liconaj/Bachelor-Thesis-AlamProject/docs/title.tex

\begin{titlepage}
    \begin{spacing}{1}
    \hypertarget{titlepage}{} % set hypertarget
    \bookmark[dest=titlepage,level=chapter]{Title Page} % add bookmark
    \begin{center}
        \vspace*{0.5cm}

        \LARGE
        % Development of a Portable and Modular Platform with Control System for Rod-Driven Continuum Parallel Robots
        \textbf{Design of a Portable Control Platform for Rod-Driven Continuum Parallel Robots}

        \vspace{2cm}
        \Large
        Josué Licona Mármol

        \large
        \vspace{1.5cm}
        \textit{A graduation project submitted in partial fulfillment \\
        of the requirements for the degree of} \\
        \vspace{0.5cm}
        Bachelor of Science in Mechanical Engineering

        \vspace{1.5cm}
        \textit{Supervisor} \\
        Jonathan Camargo Leyva, Ph.D.

        \vspace{1cm}
        % yellow and black version
        \adjincludegraphics[trim={0 0 {.5\width} 0},clip]{facultadingenieria}
        % black version
        %\includegraphics[width=0.4\textwidth, trim={{.5\width} 0 0 0},clip}]{facultadingenieria}
        \vspace{1cm}
        \\
        Department of Mechanical Engineering\\
        Universidad de los Andes\\
        Bogotá D.C., Colombia\\
        \today
    \end{center}
    \end{spacing}
\end{titlepage}
\setcounter{page}{2}
\normalsize
