liconaj/Bachelor-Thesis-AlamProject/docs/main.tex

\documentclass[a4paper,12pt,oneside]{book}
\usepackage{preamble}

\begin{document}

%=======================================
\frontmatter

\import{}{title}

% dedication
\addbookmark{Dedication}
\import{sections/}{dedication}
\normalsize

% abstract
\phantomchapter{Abstract}
\import{sections/}{abstract}

% acknowledgements
\phantomchapter{Acknowledgements}
\import{sections/}{acknowledgements}

% table of contents
\addbookmark{\contentsname}
\tableofcontents

% list of figures
\addcontent{\listfigurename}
\listoffigures

% list of tables
\addcontent{\listtablename}
\listoftables

%=======================================
\mainmatter

\chapter{Introduction}
\import{sections/}{introduction}

\chapter{Target Robot Structure}
\import{sections/}{chapter2}

\chapter{Linear Actuator}
\import{sections/}{chapter3}

\chapter{Platform Assembly}
\import{sections/}{chapter4}

\chapter{Control System Interface}
\import{sections/}{chapter5}

\chapter{Performance and Results}
\import{sections/}{chapter6}

%=======================================
\backmatter

\chapter{Conclusions}
\import{sections/}{conclusions}

\chapter{Future Work and Recommendations}
\import{sections/}{future}

% references
%\nocite{*}  % show all references
\printbibliography[
    heading=bibintoc,
    title={Bibliography}]

%=======================================
% appendices

\begin{appendices}
    \renewcommand{\thechapter}{}
    \renewcommand{\thesection}{\Alph{section}}
    %\addtocontents{toc}{\protect\setcounter{tocdepth}{1}}
    %\makeatletter
    %\addtocontents{toc}{%
    %\begingroup
    %\let\protect\l@chapter\protect\l@section
    %\let\protect\l@section\protect\l@subsection
    %}

    \section{Forces in Actuator Arm}\label{apx:arm-calcs}
    \import{appendices/}{arm-forces-calcs}

    \section{PID Tuning Code}\label{apx:pid-code}
    \import{appendices/}{pid-code}

    \section{Test Code}\label{apx:test-code}
    \import{appendices/}{test-code}

    \section{Command Line Interface Source Code}\label{apx:cli-code}
    \import{appendices/}{cli-code}

    \section{Firmware Source Code}\label{apx:firmware-code}
    \import{appendices/}{firmware-source-code}    
\end{appendices}

\end{document}
