liconaj/Bachelor-Thesis-AlamProject/docs/sections/acknowledgements.tex

\par I would like to express my sincerest gratitude to God, whose guidance has been a constant source of support throughout my life. I am particularly grateful to my family, especially my mother, whose unwavering encouragement has been a significant source of strength.
\par I am indebted to the professors who have not only imparted their knowledge but also served as exemplary mentors, shaping my understanding and passion for mechanical engineering. I would also like to express my gratitude to my classmates for their camaraderie and support. \par I would also like to extend my gratitude to Daniel Álvarez for his invaluable contribution to the actuator concept and to Santiago Usme for his assistance with the manufacturing and assembly challenges.
