liconaj/Bachelor-Thesis-AlamProject/docs/sections/conclusions.tex

The development of the Alam robot platform has demonstrated the successful integration if mechanical design, control theory, and software development throughout this project. The platform, constructed from steel rod segments and 3D-printed components, provides a robust framework for robotic experimentation and control. Notwithstanding the difficulties encountered in the completion and the electronic assembly, the platform succeeded in attaining its principal objective of offering a flexible and programmable robotic system.

The testing and experimentation phase revealed both the platform's achievements and areas for improvement. The implementation of PID control algorithms demonstrated effective position control; however, issues with overshoot and controller saturation necessitated further refinement. The difficulties encountered with linear actuators highlighted the necessity for precision manufacturing and iterative design enhancements. These insights will inform future iterations aimed at optimizing performance and reliability.

The scalability of the platform was a fundamental aspect of the overarching objective. The design and architecture provide a robust foundation for the expansion of functionality in both in software and hardware. The modular nature of the system allows for straightforward incorporation of supplementary sensors, actuators, and peripherals, thereby facilitating enhancements and customization based on specific requirements. The firmware was designed in such a way that the new commands and features can be added with a minimum of reconfiguration. Moreover, the use of standardized communication protocols guarantees compatibility with a multitude of external devices and systems. This inherent flexibility positions the platform for future developments and applications, thereby rendering it a versatile and scalable solution for various robotic projects.

In summary, the Alam robot platform serves as a foundational tool for the exploration of advanced robotics concepts and applications. By addressing challenges in mechanical design, control algorithms, and software integration, this project sets a precedent for future developments in the field of robotics.
