liconaj/Bachelor-Thesis-AlamProject/docs/sections/dedication.tex

\vspace*{2cm}

\large
\begin{flushleft}
    \noindent\textit{To my mother, Gildes Ester.}
\end{flushleft}

\vspace*{5cm}

\begin{flushright}
    \normalsize
    Success is the sum of small efforts, repeated day in, and day out. \\ --- Robert Collier
\end{flushright}
