liconaj/Bachelor-Thesis-AlamProject/docs/images/delta_robot.png

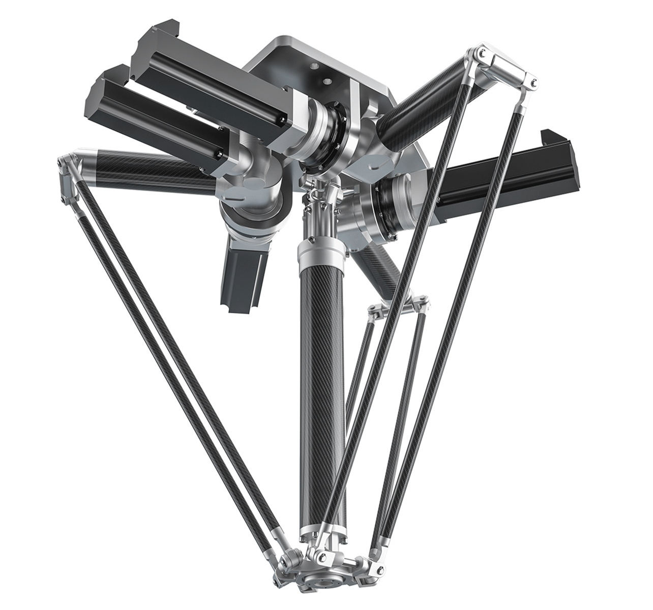
docs/images/delta_robot.png
