liconaj/Bachelor-Thesis-AlamProject/docs/images/main-connection.png

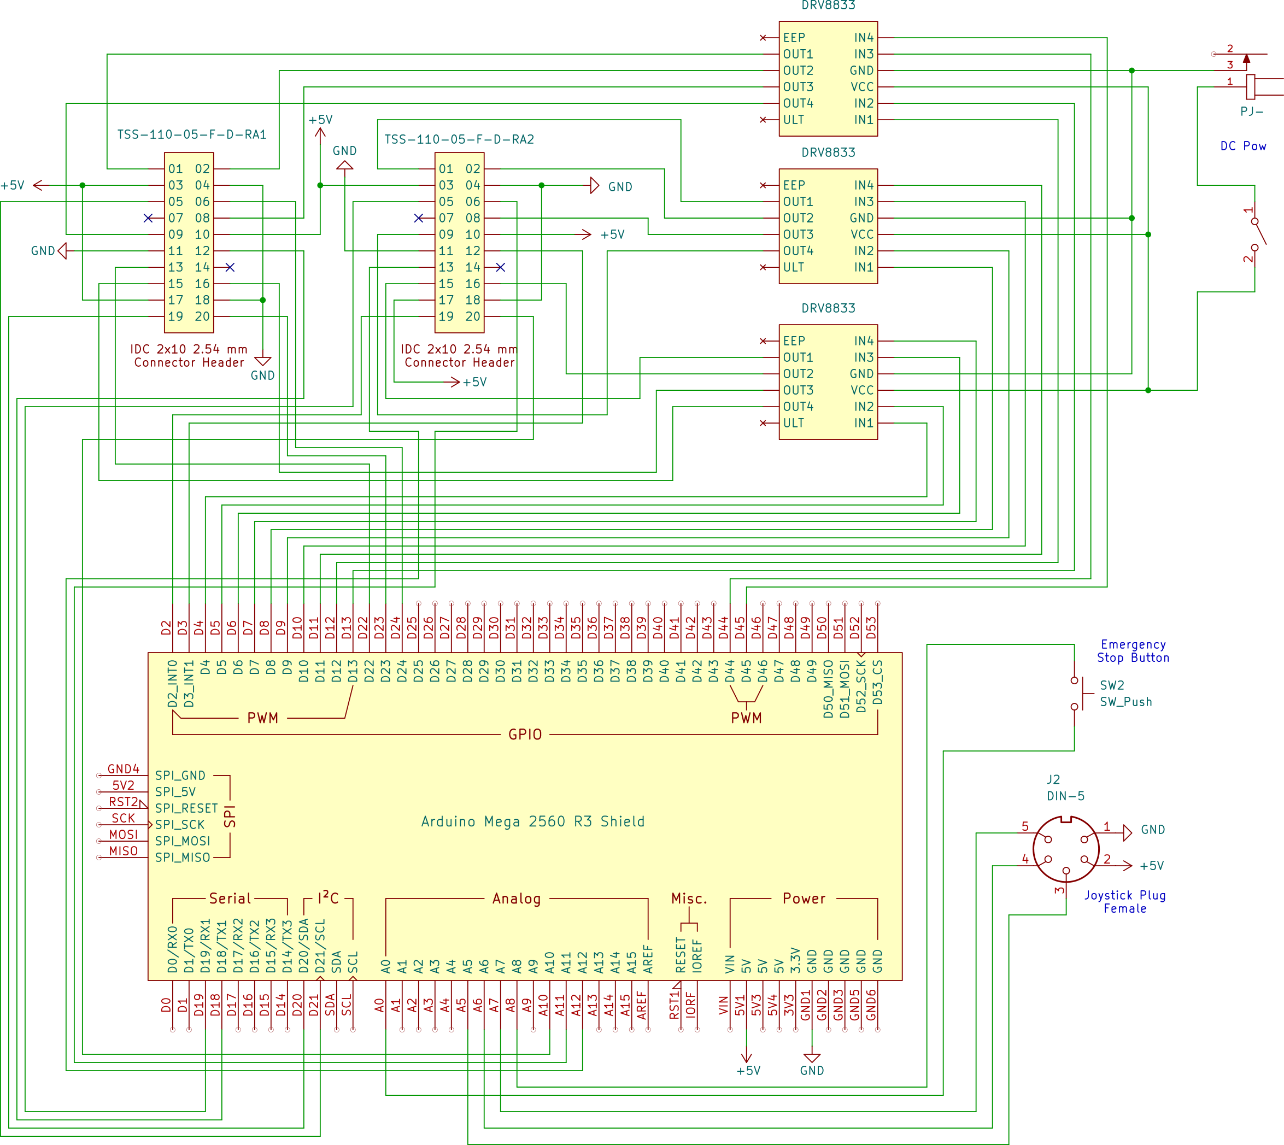
docs/images/main-connection.png
