liconaj/Bachelor-Thesis-AlamProject/docs/images/motor-connection.png

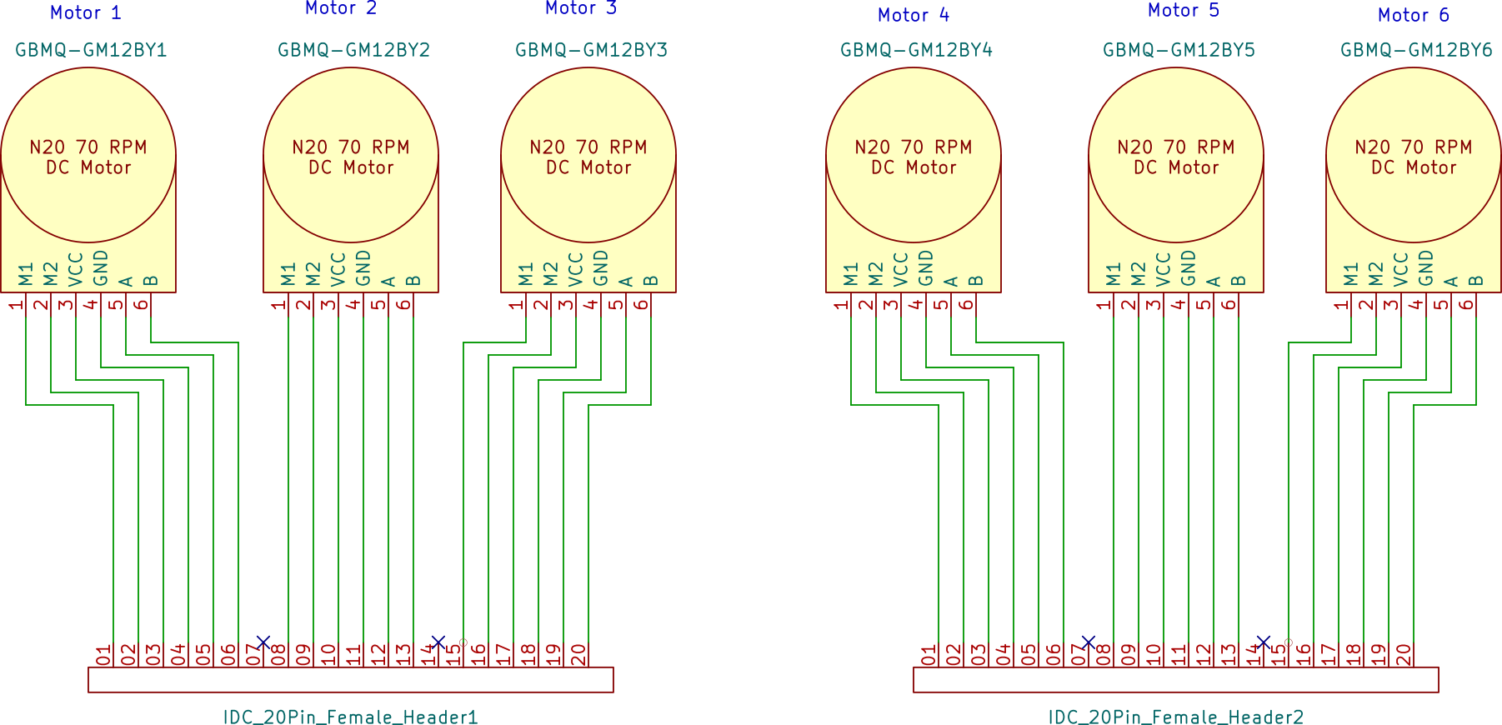
docs/images/motor-connection.png
