liconaj/Bachelor-Thesis-AlamProject/docs/appendices/test-code.tex

\begin{minted}[
    frame=lines,
    framesep=2mm,
    baselinestretch=0.9,
    fontsize=\footnotesize
    ]{gcode}
;ALAM ROBOT TEST
;BY LICONAJ (c) 2024

G4 P5000  ; WAIT 3 SECONDS
;MOVE ACTUATOR A
G1 A-60
G4 P500
G1 A0
G4 P500
;MOVE ACTUATOR B
G1 B-60
G1 P500
G1 B0
G4 P500
;MOVE ACTUATOR C
G1 C-60
G1 C0
;MOVE ACTUATORS A AND B
G4 P1000
G1 A-60 B-60
G4 P500
G1 A0 B0
;MOVE ACTUATORS B AND C
G4 P1000
G1 B-60 C-60
G4 P500
G1 B0 C0
;MOVE ACTUATORS C AND A
G4 P1000
G1 C-60 A-60
G4 P500
G1 C0 A0
;MOVE ALL ACTUATORS
G4 P1000
G1 A-60 B-60 C-60
G4 P1000
;MOVE ACTUATORS A B C TO HOME
G28 A B C
\end{minted}
