liconaj/Bachelor-Thesis-AlamProject/docs/images/input-output-signals.pdf

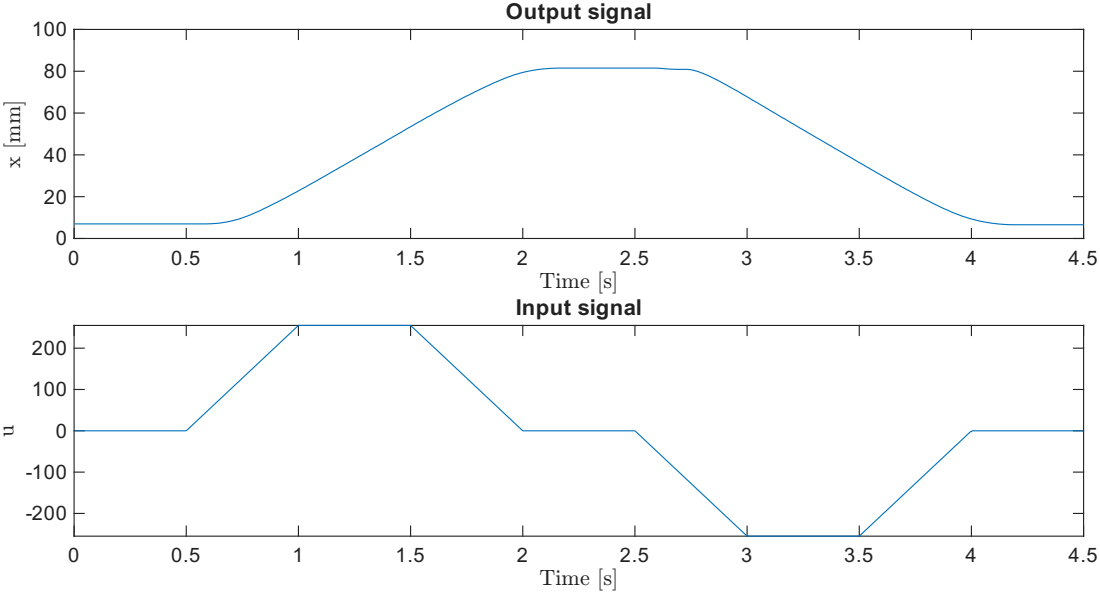
[picture p67: page 1]
