liconaj/Bachelor-Thesis-AlamProject/docs/images/facultadingenieria-eps-converted-to.pdf

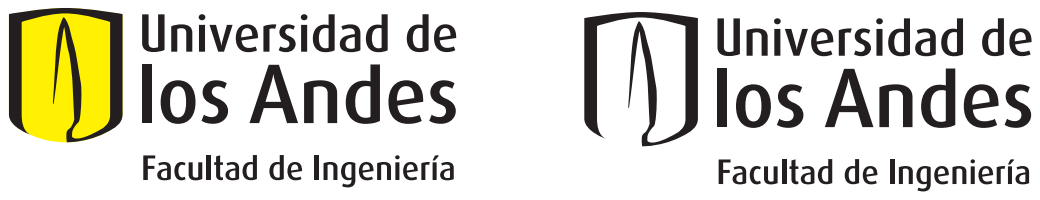
[picture p68: page 1]
