liconaj/Bachelor-Thesis-AlamProject/docs/schematic/main_connection.kicad_sch

## KiCad design docs/schematic/main_connection.kicad_sch (2024-06-28)

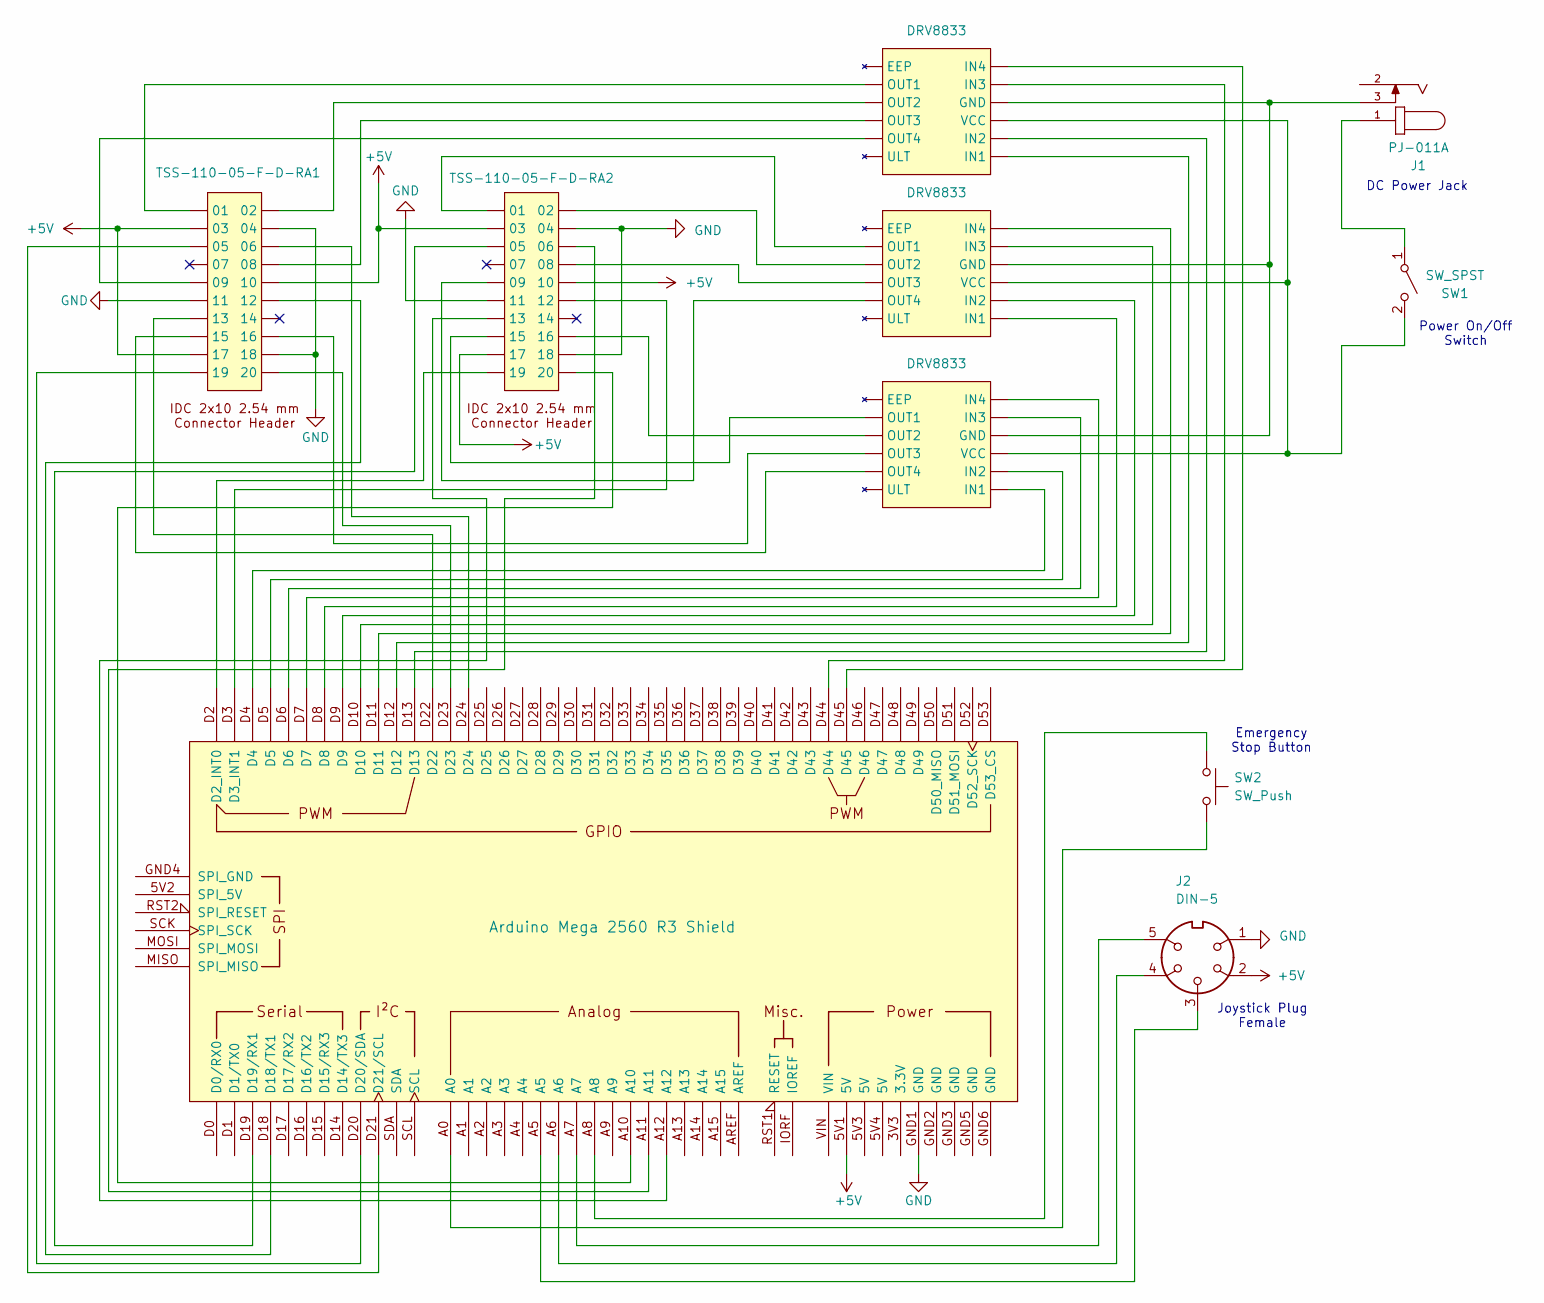
[picture p69: schematic main_connection.kicad_sch]

Parts:
A1: Arduino Mega 2560 R3 Shield; Arduino_Mega2560_R3_Shield
DRV8833: (no value)
J1: PJ-011A; CUI_PJ-011A
J2: DIN-5
SW1: SW_SPST
SW2: SW_Push
TSS-110-05-F-D-RA1, TSS-110-05-F-D-RA2: (no value)

Connections:
+5V: A1.5V1 (5V), J2.2, TSS-110-05-F-D-RA1., TSS-110-05-F-D-RA2.
GND: A1.GND1 (GND), J2.1, TSS-110-05-F-D-RA1., TSS-110-05-F-D-RA2.
unnamed: A1.A0, SW2.2
unnamed: A1.A5, J2.3
unnamed: A1.A6, J2.4
unnamed: A1.A7, J2.5
unnamed: A1.A8, SW2.1
unnamed: A1.A10, TSS-110-05-F-D-RA2.
unnamed: A1.A11, TSS-110-05-F-D-RA2.
unnamed: A1.A12, TSS-110-05-F-D-RA2.
unnamed: A1.D2 (D2_INT0), TSS-110-05-F-D-RA2.
unnamed: A1.D3 (D3_INT1), TSS-110-05-F-D-RA2.
unnamed: A1.D4, DRV8833.
unnamed: A1.D5, DRV8833.
unnamed: A1.D6, DRV8833.
unnamed: A1.D7, DRV8833.
unnamed: A1.D8, DRV8833.
unnamed: A1.D9, DRV8833.
unnamed: A1.D10, DRV8833.
unnamed: A1.D11, DRV8833.
unnamed: A1.D12, DRV8833.
unnamed: A1.D13, DRV8833.
unnamed: A1.D18 (D18/TX1), TSS-110-05-F-D-RA1.
unnamed: A1.D19 (D19/RX1), TSS-110-05-F-D-RA2.
unnamed: A1.D20 (D20/SDA), TSS-110-05-F-D-RA1.
unnamed: A1.D21 (D21/SCL), TSS-110-05-F-D-RA1.
unnamed: A1.D22, TSS-110-05-F-D-RA1.
unnamed: A1.D23, TSS-110-05-F-D-RA1.
unnamed: A1.D24, TSS-110-05-F-D-RA1.
unnamed: A1.D44, DRV8833.
unnamed: A1.D45, DRV8833.
unnamed: DRV8833., J1.3, SW1.2 (B), TSS-110-05-F-D-RA1., TSS-110-05-F-D-RA2.
unnamed: J1.1, SW1.1 (A)

Notes on the sheet:
DC Power Jack
Power On/Off Switch
Joystick Plug Female
Emergency Stop Button
