liconaj/Bachelor-Thesis-AlamProject/docs/schematic/motor_connection.kicad_sch

## KiCad design docs/schematic/motor_connection.kicad_sch (2024-07-04)

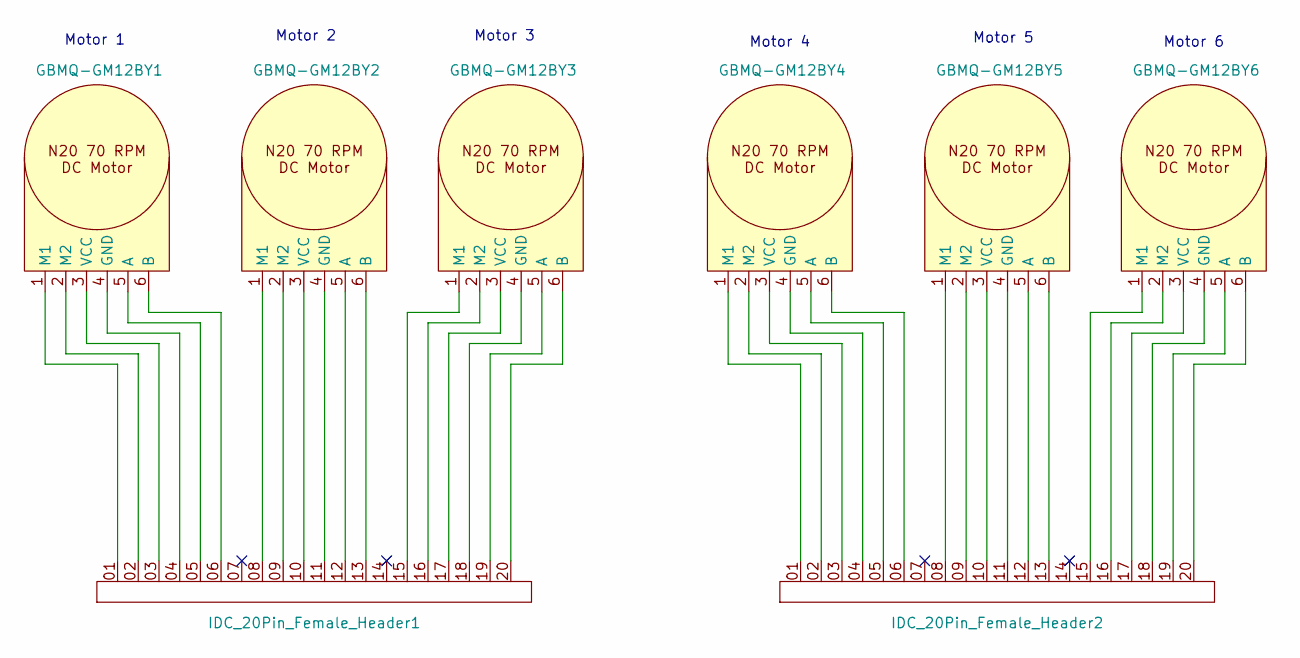
[picture p70: schematic motor_connection.kicad_sch]

Parts:
GBMQ-GM12BY1, GBMQ-GM12BY2, GBMQ-GM12BY3, GBMQ-GM12BY4, GBMQ-GM12BY5, GBMQ-GM12BY6: (no value)
IDC_20Pin_Female_Header1, IDC_20Pin_Female_Header2: (no value)

Connections:
unnamed: GBMQ-GM12BY1.1 (M1), IDC_20Pin_Female_Header1.01
unnamed: GBMQ-GM12BY1.2 (M2), IDC_20Pin_Female_Header1.02
unnamed: GBMQ-GM12BY1.3 (VCC), IDC_20Pin_Female_Header1.03
unnamed: GBMQ-GM12BY1.4 (GND), IDC_20Pin_Female_Header1.04
unnamed: GBMQ-GM12BY1.5 (A), IDC_20Pin_Female_Header1.05
unnamed: GBMQ-GM12BY1.6 (B), IDC_20Pin_Female_Header1.06
unnamed: GBMQ-GM12BY2.1 (M1), IDC_20Pin_Female_Header1.08
unnamed: GBMQ-GM12BY2.2 (M2), IDC_20Pin_Female_Header1.09
unnamed: GBMQ-GM12BY2.3 (VCC), IDC_20Pin_Female_Header1.10
unnamed: GBMQ-GM12BY2.4 (GND), IDC_20Pin_Female_Header1.11
unnamed: GBMQ-GM12BY2.5 (A), IDC_20Pin_Female_Header1.12
unnamed: GBMQ-GM12BY2.6 (B), IDC_20Pin_Female_Header1.13
unnamed: GBMQ-GM12BY3.2 (M2), IDC_20Pin_Female_Header1.16
unnamed: GBMQ-GM12BY3.3 (VCC), IDC_20Pin_Female_Header1.17
unnamed: GBMQ-GM12BY3.4 (GND), IDC_20Pin_Female_Header1.18
unnamed: GBMQ-GM12BY3.5 (A), IDC_20Pin_Female_Header1.19
unnamed: GBMQ-GM12BY3.6 (B), IDC_20Pin_Female_Header1.20
unnamed: GBMQ-GM12BY4.1 (M1), IDC_20Pin_Female_Header2.01
unnamed: GBMQ-GM12BY4.2 (M2), IDC_20Pin_Female_Header2.02
unnamed: GBMQ-GM12BY4.3 (VCC), IDC_20Pin_Female_Header2.03
unnamed: GBMQ-GM12BY4.4 (GND), IDC_20Pin_Female_Header2.04
unnamed: GBMQ-GM12BY4.5 (A), IDC_20Pin_Female_Header2.05
unnamed: GBMQ-GM12BY4.6 (B), IDC_20Pin_Female_Header2.06
unnamed: GBMQ-GM12BY5.1 (M1), IDC_20Pin_Female_Header2.08
unnamed: GBMQ-GM12BY5.2 (M2), IDC_20Pin_Female_Header2.09
unnamed: GBMQ-GM12BY5.3 (VCC), IDC_20Pin_Female_Header2.10
unnamed: GBMQ-GM12BY5.4 (GND), IDC_20Pin_Female_Header2.11
unnamed: GBMQ-GM12BY5.5 (A), IDC_20Pin_Female_Header2.12
unnamed: GBMQ-GM12BY5.6 (B), IDC_20Pin_Female_Header2.13
unnamed: GBMQ-GM12BY6.2 (M2), IDC_20Pin_Female_Header2.16
unnamed: GBMQ-GM12BY6.3 (VCC), IDC_20Pin_Female_Header2.17
unnamed: GBMQ-GM12BY6.4 (GND), IDC_20Pin_Female_Header2.18
unnamed: GBMQ-GM12BY6.5 (A), IDC_20Pin_Female_Header2.19
unnamed: GBMQ-GM12BY6.6 (B), IDC_20Pin_Female_Header2.20

Notes on the sheet:
Motor 2
Motor 1
Motor 4
Motor 5
Motor 6
Motor 3
