liconaj/Bachelor-Thesis-AlamProject/(commit log)

2024-06-19 KiCad schematic
    [main_connection.kicad_sch, motor_connection.kicad_sch]
2024-06-19 Firmware updated with local libraries and pins of all actuators
2024-06-28 Dummy text removal; some tables and images
    [main_connection.kicad_sch]
2024-07-04 Change gear ratio
2024-07-04 Add new images
    [motor_connection.kicad_sch]
2024-07-05 Update test code to show actuators position
2024-07-05 Add images of complete prototype
